Jaystonian/SuperVIC/CMicro-Keyboard/pics/CMicro-Keyboard.png

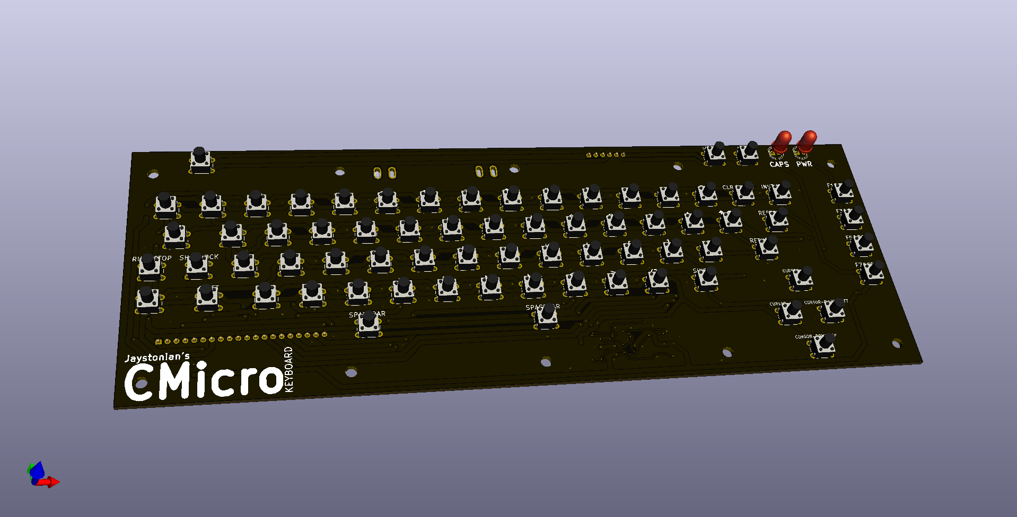
CMicro-Keyboard/pics/CMicro-Keyboard.png
