Jaystonian/SuperVIC/SuperVIC-Motherboard/pics/SuperVIC-Motherboard1.png

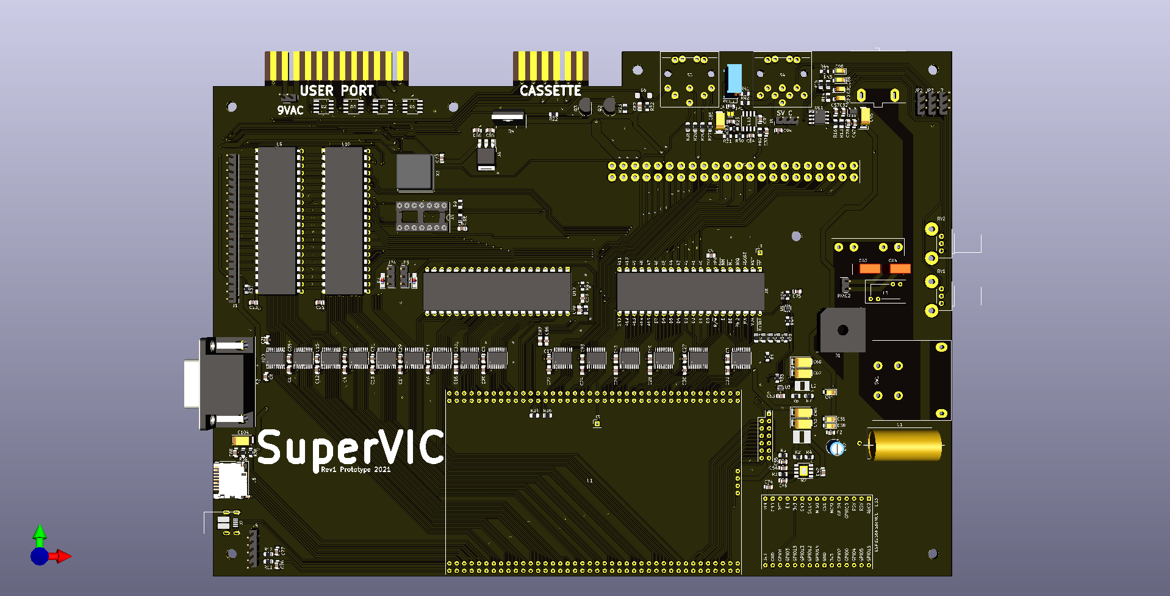
SuperVIC-Motherboard/pics/SuperVIC-Motherboard1.png
