Jaystonian/SuperVIC/SuperVIC-Motherboard/pics/IMG_20210614_160904_6.jpg

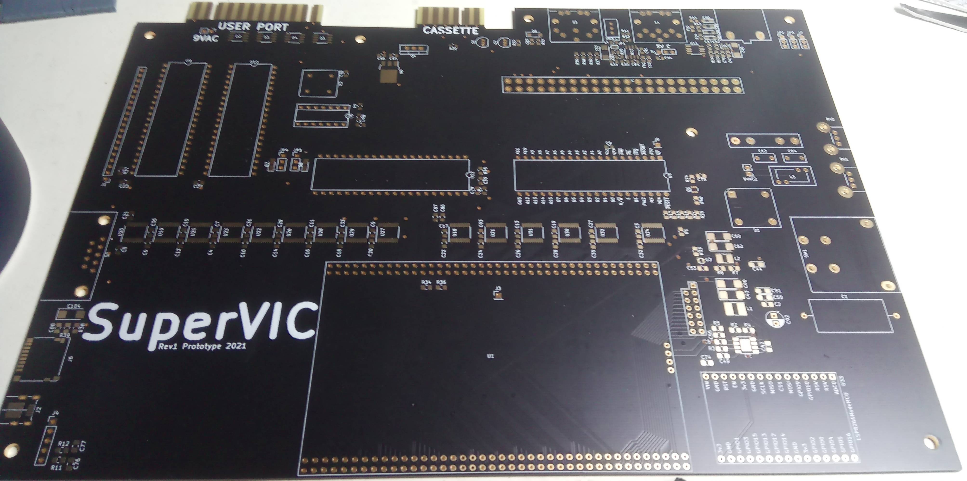
SuperVIC-Motherboard/pics/IMG_20210614_160904_6.jpg
