Jaystonian/SuperVIC/SuperVIC-STM32/pics/Capture-1.png

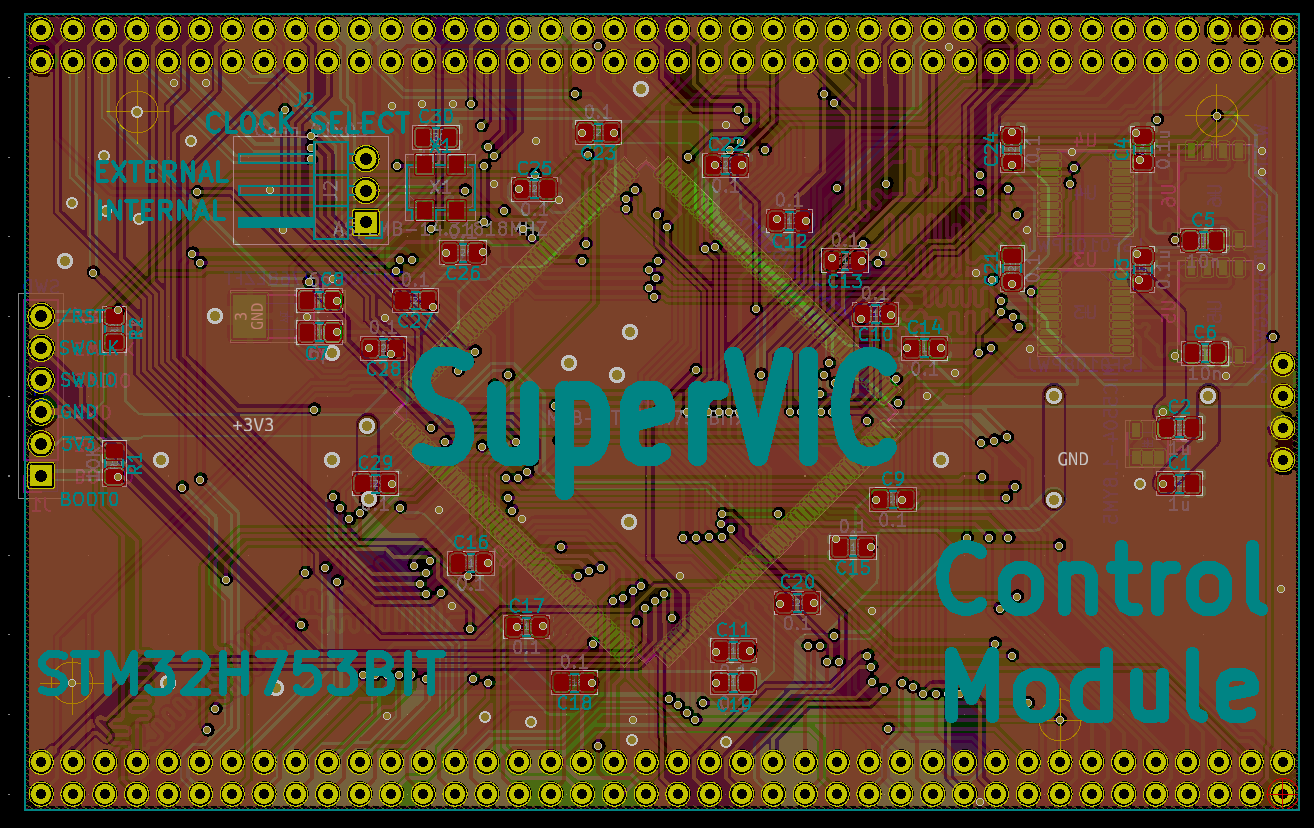
SuperVIC-STM32/pics/Capture-1.png
