Jaystonian/SuperVIC/SuperVIC-STM32/pics/SuperVIC-STM32-bottom.png

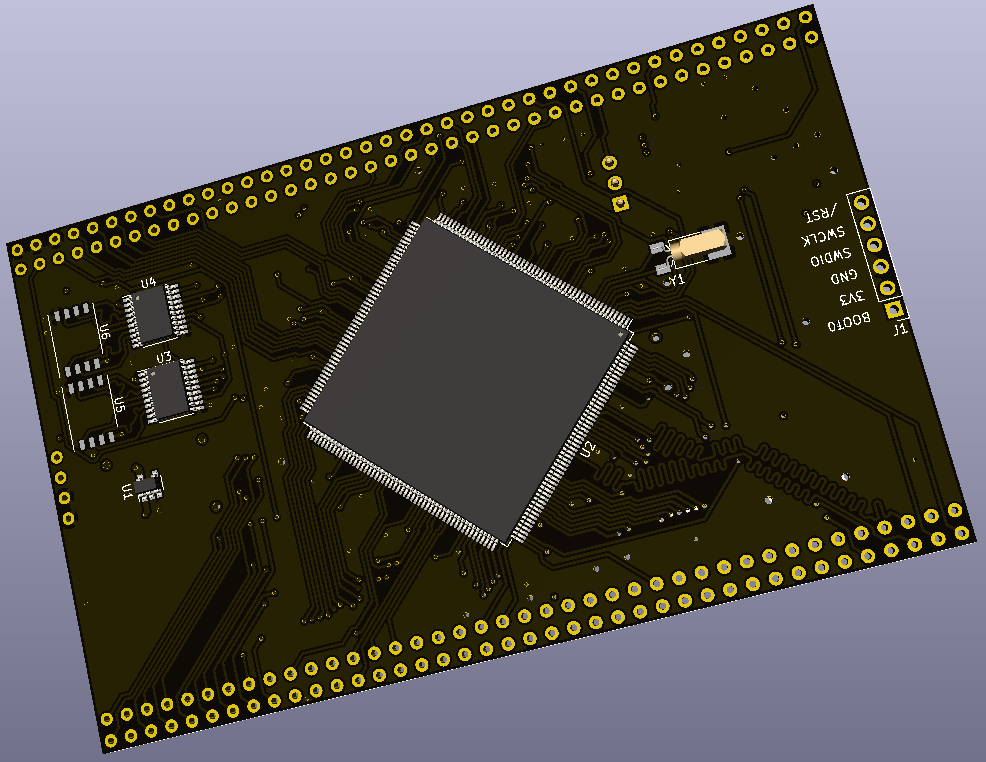
SuperVIC-STM32/pics/SuperVIC-STM32-bottom.png
