Jaystonian/SuperVIC/SuperVIC-STM32/pics/SuperVIC-STM32-top.png

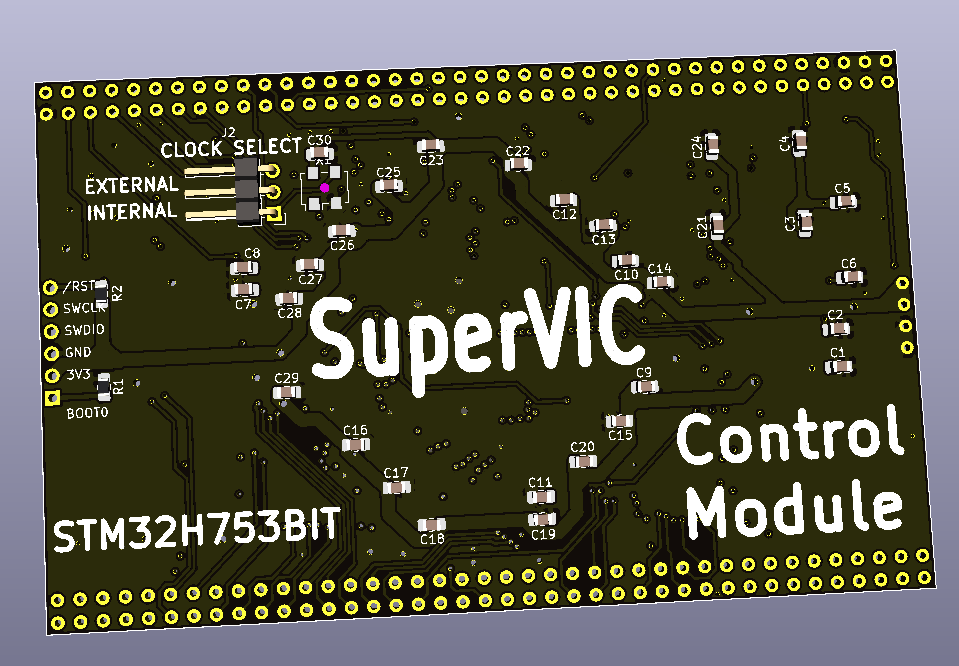
SuperVIC-STM32/pics/SuperVIC-STM32-top.png
