Jaystonian/SuperVIC/3D_Print/bottom_v1.stl

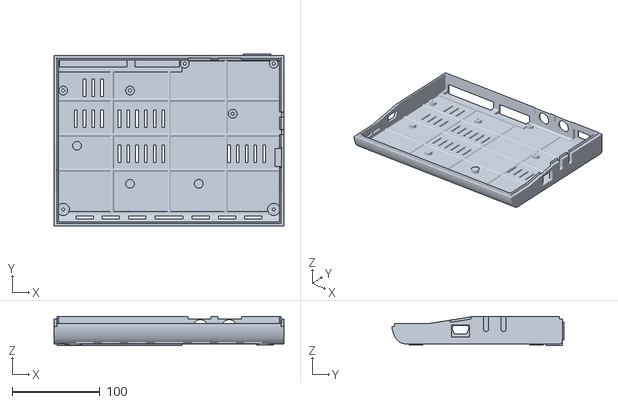
[picture p7: CAD file, 2021-06-18]
3D_Print/bottom_v1.stl
262.5 x 196.8 x 33.2
