Jaystonian/SuperVIC/CMicro-Keyboard/Print3D/protocase_rev0/cmicro-proto-external-top.stl

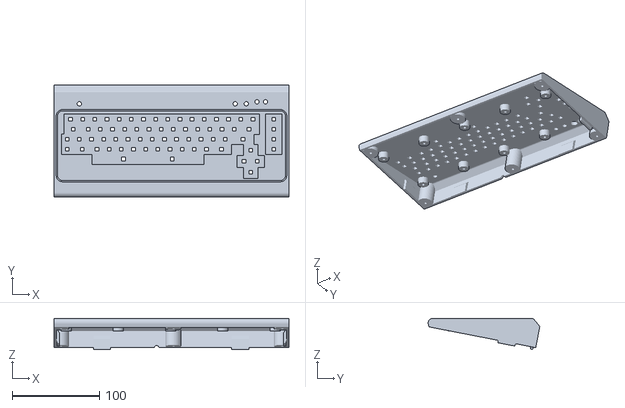
[picture p8: CAD file, 2021-06-15]
CMicro-Keyboard/Print3D/protocase_rev0/cmicro-proto-external-top.stl
270.0 x 128.3 x 35.7
