Jaystonian/SuperVIC/CMicro-Keyboard/Print3D/protocase_rev0/cmicro-proto-external-bottom.stl

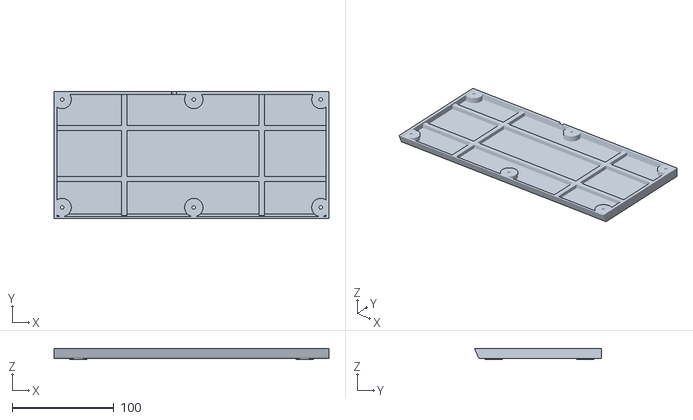
[picture p9: CAD file, 2021-06-15]
CMicro-Keyboard/Print3D/protocase_rev0/cmicro-proto-external-bottom.stl
270.0 x 125.0 x 11.2
