Jaystonian/SuperVIC/SuperVIC-STM32/SuperVIC-STM32.pdf

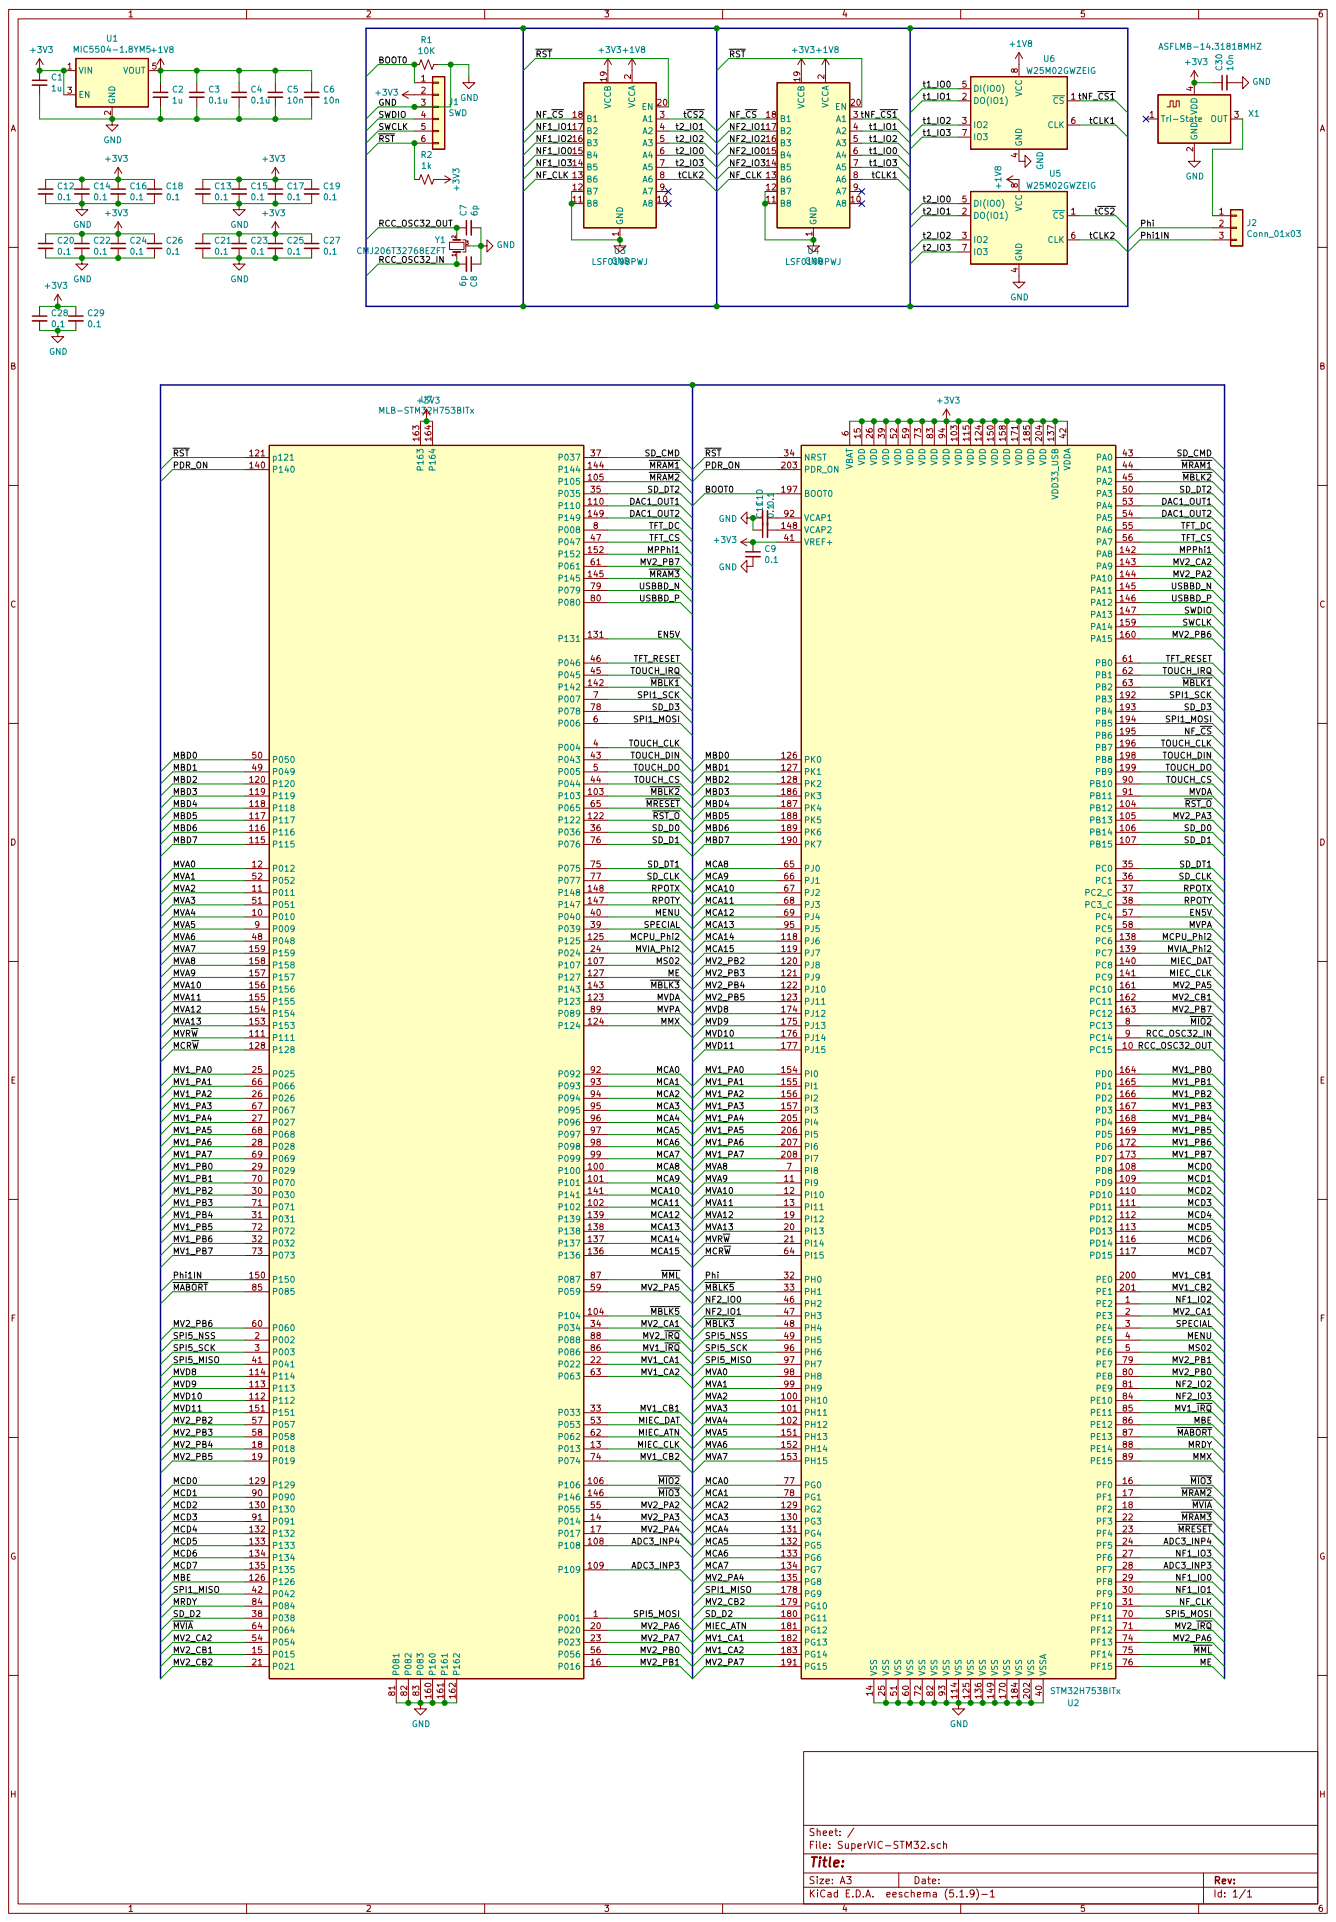
[picture p10: page 1]

6 VCAP1 92 VCAP2 148 VDD 103 VDD 115 VDD 124 VDD 15 VDD 150 VDD 158 VDD 171 VDD 185 VDD 204 VDD 26 VDD 39 VDD 52 VDD 59 VDD 73 VDD 83 VDD 94 VDD33_USB 137 VDDA 42 VREF+ 41 VSS 114 VSS 125 VSS 136 VSS 14 VSS 149 VSS 170 VSS 184 VSS 202 VSS 25 VSS 51 VSS 60 VSS 72 VSS 82 VSS 93 VSSA 40 U2 STM32H753BITx

File: SuperVIC-STM32.sch Sheet: /
