Jaystonian/SuperVIC/CMicro-Keyboard/CMicro-Keyboard.pdf

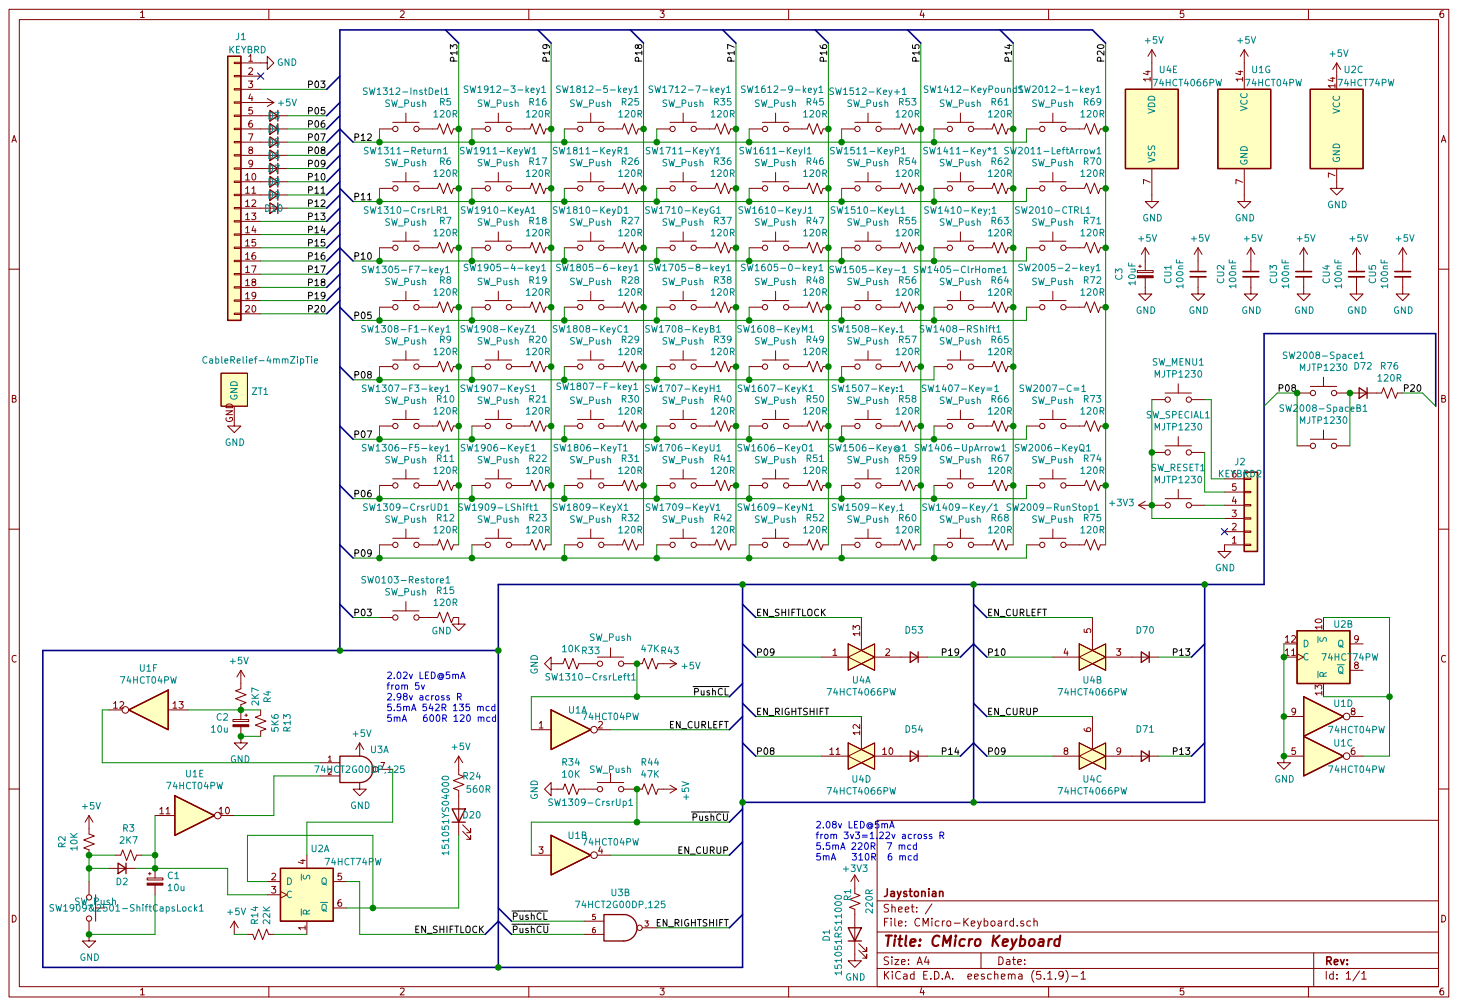
[picture p11: page 1]

File: CMicro-Keyboard.sch Sheet: / Jaystonian

Id: 1/1 Title: CMicro Keyboard
