Jaystonian/SuperVIC/SuperVIC-STM32/SuperVIC-STM32.kicad_pcb

## KiCad design SuperVIC-STM32/SuperVIC-STM32.kicad_pcb (2021-06-15)

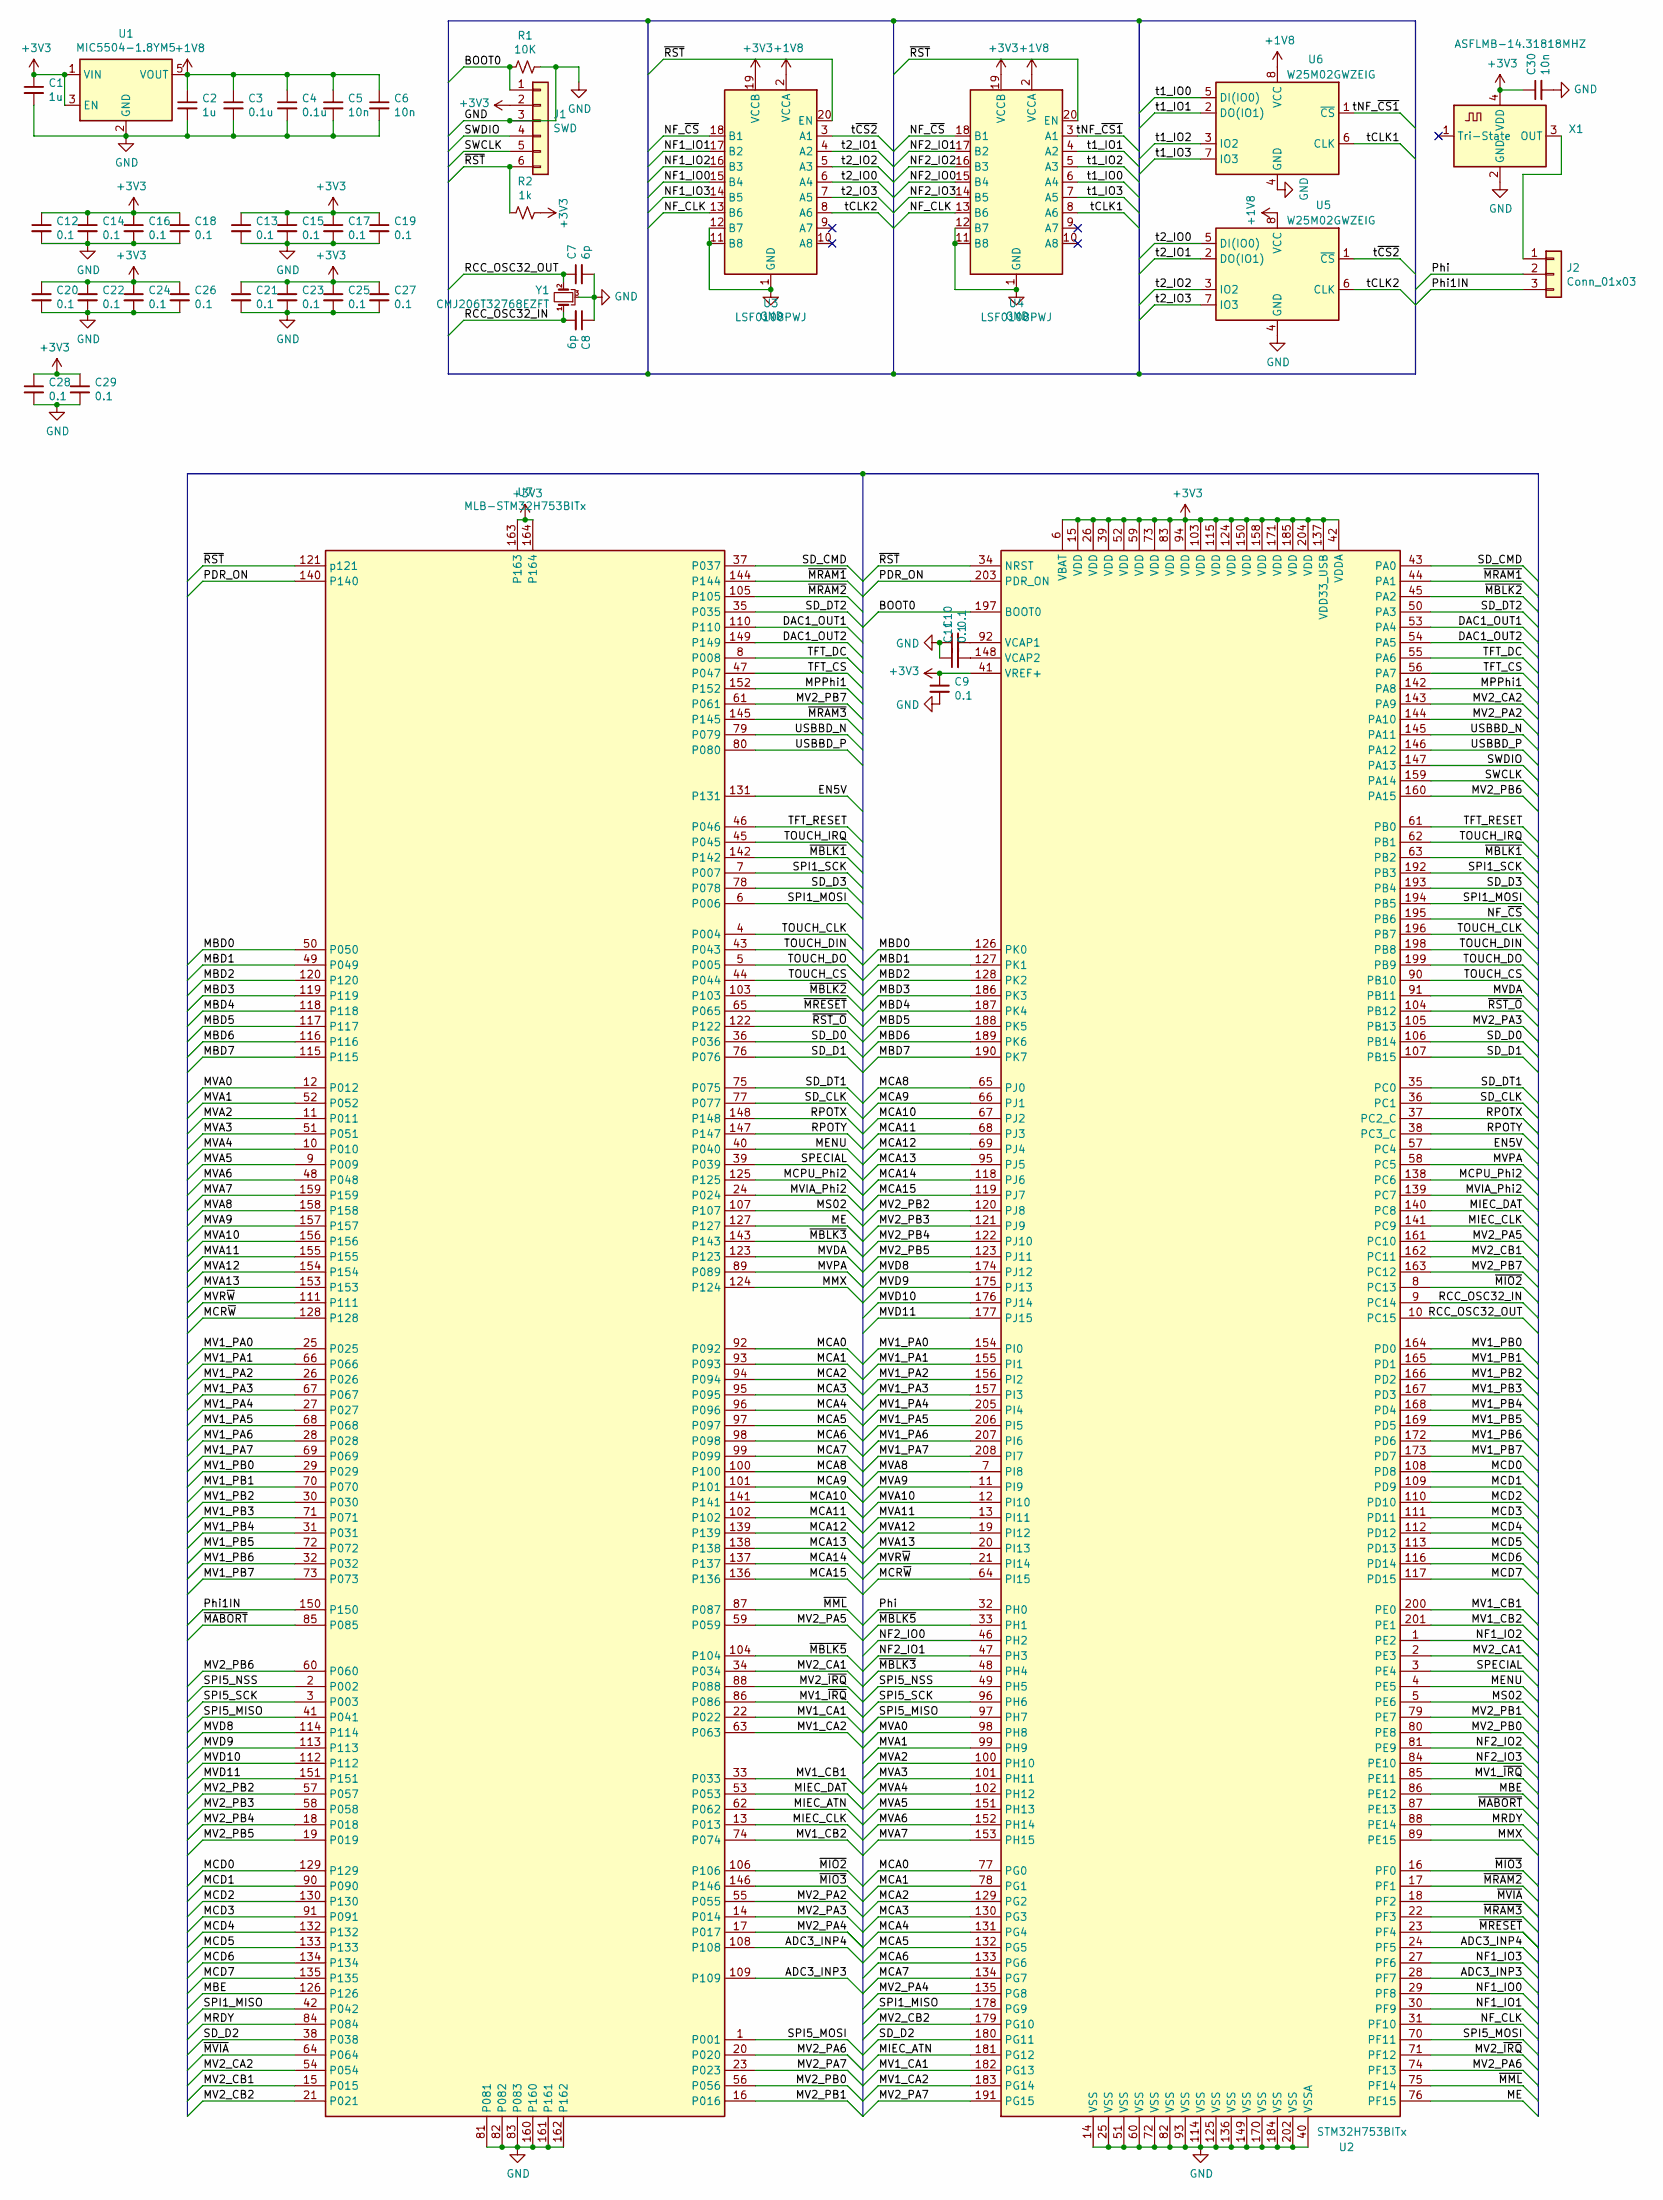
[picture p12: schematic SuperVIC-STM32.sch]

Parts:
C1, C2: 1u; C_0805_2012Metric_Pad1.15x1.40mm_HandSolder
C3, C4: 0.1u; C_0805_2012Metric_Pad1.15x1.40mm_HandSolder
C5, C6, C30: 10n; C_0805_2012Metric_Pad1.15x1.40mm_HandSolder
C7, C8: 6p; C_0805_2012Metric_Pad1.15x1.40mm_HandSolder
C9, C10, C11, C12, C13, C14, C15, C16, C17, C18, C19, C20, C21, C22, C23, C24, C25, C26, C27, C28, C29: 0.1; C_0805_2012Metric_Pad1.15x1.40mm_HandSolder
J1: SWD; PinHeader_1x06_P2.54mm_Vertical
J2: Conn_01x03; PinHeader_1x03_P2.54mm_Horizontal
R1: 10K; R_0805_2012Metric_Pad1.15x1.40mm_HandSolder
R2: 1k; R_0805_2012Metric_Pad1.15x1.40mm_HandSolder
U1: MIC5504-1.8YM5; SOT-23-5
U2: STM32H753BITx; LQFP-208_28x28mm_P0.5mm
U3, U4: LSF0108PWJ; TSSOP-20_4.4x6.5mm_P0.65mm
U5, U6: W25M02GWZEIG; WSON-8_8x6mm
U7: MLB-STM32H753BITx
X1: ASFLMB-14.31818MHZ; Oscillator_SMD_Abracon_ASF-4Pin_5.0x3.2mm_Handsoldering
Y1: CMJ206T32768EZFT; Crystal_SMD_CMJ206T

Connections:
+1V8: C2.1, C3.1, C4.1, C5.1, C6.1, U1.5 (VOUT), U3.2 (VCCA), U4.2 (VCCA), U5.8 (VCC), U6.8 (VCC)
+3V3: C1.1, C9.1, C12.1, C13.1, C14.1, C15.1, C16.1, C17.1, C18.1, C19.1, C20.1, C21.1, C22.1, C23.1, C24.1, C25.1, C26.1, C27.1, C28.1, C29.1, C30.1, J1.2, R2.1, U1.1 (VIN), U1.3 (EN), U2.6 (VBAT), U2.15 (VDD), U2.26 (VDD), U2.39 (VDD), U2.41 (VREF+), U2.42 (VDDA), U2.52 (VDD), U2.59 (VDD), U2.73 (VDD), U2.83 (VDD), U2.94 (VDD), U2.103 (VDD), U2.115 (VDD), U2.124 (VDD), U2.137 (VDD33_USB), U2.150 (VDD), U2.158 (VDD), U2.171 (VDD), U2.185 (VDD), U2.204 (VDD), U3.19 (VCCB), U4.19 (VCCB), U7.163, U7.164, X1.4 (VDD)
/ADC3_INP3: U2.28 (PF7), U7.109
/ADC3_INP4: U2.24 (PF5), U7.108
/BOOT0: J1.1, R1.2, U2.197 (BOOT0)
/DAC1_OUT1: U2.53 (PA4), U7.110
/DAC1_OUT2: U2.54 (PA5), U7.149
/EN5V: U2.57 (PC4), U7.131
/MBD0: U2.126 (PK0), U7.50
/MBD1: U2.127 (PK1), U7.49
/MBD2: U2.128 (PK2), U7.120
/MBD3: U2.186 (PK3), U7.119
/MBD4: U2.187 (PK4), U7.118
/MBD5: U2.188 (PK5), U7.117
/MBD6: U2.189 (PK6), U7.116
/MBD7: U2.190 (PK7), U7.115
/MBE: U2.86 (PE12), U7.126
/MCA0: U2.77 (PG0), U7.92
/MCA1: U2.78 (PG1), U7.93
/MCA2: U2.129 (PG2), U7.94
/MCA3: U2.130 (PG3), U7.95
/MCA4: U2.131 (PG4), U7.96
/MCA5: U2.132 (PG5), U7.97
/MCA6: U2.133 (PG6), U7.98
/MCA7: U2.134 (PG7), U7.99
/MCA8: U2.65 (PJ0), U7.100
/MCA9: U2.66 (PJ1), U7.101
/MCA10: U2.67 (PJ2), U7.141
/MCA11: U2.68 (PJ3), U7.102
/MCA12: U2.69 (PJ4), U7.139
/MCA13: U2.95 (PJ5), U7.138
/MCA14: U2.118 (PJ6), U7.137
/MCA15: U2.119 (PJ7), U7.136
/MCD0: U2.108 (PD8), U7.129
/MCD1: U2.109 (PD9), U7.90
/MCD2: U2.110 (PD10), U7.130
/MCD3: U2.111 (PD11), U7.91
/MCD4: U2.112 (PD12), U7.132
/MCD5: U2.113 (PD13), U7.133
/MCD6: U2.116 (PD14), U7.134
/MCD7: U2.117 (PD15), U7.135
/MCPU_Phi2: U2.138 (PC6), U7.125
/MCR~W: U2.64 (PI15), U7.128
/ME: U2.76 (PF15), U7.127
/MENU: U2.4 (PE5), U7.40
/MIEC_ATN: U2.181 (PG12), U7.62
/MIEC_CLK: U2.141 (PC9), U7.13
/MIEC_DAT: U2.140 (PC8), U7.53
/MMX: U2.89 (PE15), U7.124
/MPPhi1: U2.142 (PA8), U7.152
/MRDY: U2.88 (PE14), U7.84
/MS02: U2.5 (PE6), U7.107
/MV1_CA1: U2.182 (PG13), U7.22
/MV1_CA2: U2.183 (PG14), U7.63
/MV1_CB1: U2.200 (PE0), U7.33
/MV1_CB2: U2.201 (PE1), U7.74
/MV1_PA0: U2.154 (PI0), U7.25
/MV1_PA1: U2.155 (PI1), U7.66
/MV1_PA2: U2.156 (PI2), U7.26
/MV1_PA3: U2.157 (PI3), U7.67
/MV1_PA4: U2.205 (PI4), U7.27
/MV1_PA5: U2.206 (PI5), U7.68
/MV1_PA6: U2.207 (PI6), U7.28
/MV1_PA7: U2.208 (PI7), U7.69
/MV1_PB0: U2.164 (PD0), U7.29
/MV1_PB1: U2.165 (PD1), U7.70
/MV1_PB2: U2.166 (PD2), U7.30
/MV1_PB3: U2.167 (PD3), U7.71
/MV1_PB4: U2.168 (PD4), U7.31
/MV1_PB5: U2.169 (PD5), U7.72
/MV1_PB6: U2.172 (PD6), U7.32
/MV1_PB7: U2.173 (PD7), U7.73
/MV1_~IRQ: U2.85 (PE11), U7.86
/MV2_CA1: U2.2 (PE3), U7.34
/MV2_CA2: U2.143 (PA9), U7.54
/MV2_CB1: U2.162 (PC11), U7.15
/MV2_CB2: U2.179 (PG10), U7.21
/MV2_PA2: U2.144 (PA10), U7.55
/MV2_PA3: U2.105 (PB13), U7.14
/MV2_PA4: U2.135 (PG8), U7.17
/MV2_PA5: U2.161 (PC10), U7.59
/MV2_PA6: U2.74 (PF13), U7.20
/MV2_PA7: U2.191 (PG15), U7.23
/MV2_PB0: U2.80 (PE8), U7.56
/MV2_PB1: U2.79 (PE7), U7.16
/MV2_PB2: U2.120 (PJ8), U7.57
/MV2_PB3: U2.121 (PJ9), U7.58
/MV2_PB4: U2.122 (PJ10), U7.18
/MV2_PB5: U2.123 (PJ11), U7.19
/MV2_PB6: U2.160 (PA15), U7.60
/MV2_PB7: U2.163 (PC12), U7.61
/MV2_~IRQ: U2.71 (PF12), U7.88
/MVA0: U2.98 (PH8), U7.12
/MVA1: U2.99 (PH9), U7.52
/MVA2: U2.100 (PH10), U7.11
/MVA3: U2.101 (PH11), U7.51
/MVA4: U2.102 (PH12), U7.10
/MVA5: U2.151 (PH13), U7.9
/MVA6: U2.152 (PH14), U7.48
/MVA7: U2.153 (PH15), U7.159
/MVA8: U2.7 (PI8), U7.158
/MVA9: U2.11 (PI9), U7.157
/MVA10: U2.12 (PI10), U7.156
/MVA11: U2.13 (PI11), U7.155
/MVA12: U2.19 (PI12), U7.154
/MVA13: U2.20 (PI13), U7.153
/MVD8: U2.174 (PJ12), U7.114
/MVD9: U2.175 (PJ13), U7.113
/MVD10: U2.176 (PJ14), U7.112
/MVD11: U2.177 (PJ15), U7.151
/MVDA: U2.91 (PB11), U7.123
/MVIA_Phi2: U2.139 (PC7), U7.24
/MVPA: U2.58 (PC5), U7.89
/MVR~W: U2.21 (PI14), U7.111
/NF1_IO0: U2.29 (PF8), U3.15 (B4)
/NF1_IO1: U2.30 (PF9), U3.17 (B2)
/NF1_IO2: U2.1 (PE2), U3.16 (B3)
/NF1_IO3: U2.27 (PF6), U3.14 (B5)
/NF2_IO0: U2.46 (PH2), U4.15 (B4)
/NF2_IO1: U2.47 (PH3), U4.17 (B2)
/NF2_IO2: U2.81 (PE9), U4.16 (B3)
/NF2_IO3: U2.84 (PE10), U4.14 (B5)
/NF_CLK: U2.31 (PF10), U3.13 (B6), U4.13 (B6)
/NF_~CS: U2.195 (PB6), U3.18 (B1), U4.18 (B1)
/PDR_ON: U2.203 (PDR_ON), U7.140
/Phi: J2.2, U2.32 (PH0)
/Phi1IN: J2.3, U7.150
/RCC_OSC32_IN: C8.2, U2.9 (PC14), Y1.1
/RCC_OSC32_OUT: C7.1, U2.10 (PC15), Y1.2
/RPOTX: U2.37 (PC2_C), U7.148
/RPOTY: U2.38 (PC3_C), U7.147
/SD_CLK: U2.36 (PC1), U7.77
/SD_CMD: U2.43 (PA0), U7.37
/SD_D0: U2.106 (PB14), U7.36
/SD_D1: U2.107 (PB15), U7.76
/SD_D2: U2.180 (PG11), U7.38
/SD_D3: U2.193 (PB4), U7.78
/SD_DT1: U2.35 (PC0), U7.75
/SD_DT2: U2.50 (PA3), U7.35
/SPECIAL: U2.3 (PE4), U7.39
/SPI1_MISO: U2.178 (PG9), U7.42
/SPI1_MOSI: U2.194 (PB5), U7.6
/SPI1_SCK: U2.192 (PB3), U7.7
/SPI5_MISO: U2.97 (PH7), U7.41
/SPI5_MOSI: U2.70 (PF11), U7.1
/SPI5_NSS: U2.49 (PH5), U7.2
/SPI5_SCK: U2.96 (PH6), U7.3
/SWCLK: J1.5, U2.159 (PA14)
/SWDIO: J1.4, U2.147 (PA13)
/TFT_CS: U2.56 (PA7), U7.47
/TFT_DC: U2.55 (PA6), U7.8
/TFT_RESET: U2.61 (PB0), U7.46
/TOUCH_CLK: U2.196 (PB7), U7.4
/TOUCH_CS: U2.90 (PB10), U7.44
/TOUCH_DIN: U2.198 (PB8), U7.43
/TOUCH_DO: U2.199 (PB9), U7.5
/TOUCH_IRQ: U2.62 (PB1), U7.45
/USBBD_N: U2.145 (PA11), U7.79
/USBBD_P: U2.146 (PA12), U7.80
/t1_IO0: U4.6 (A4), U6.5 (DI(IO0))
/t1_IO1: U4.4 (A2), U6.2 (DO(IO1))
/t1_IO2: U4.5 (A3), U6.3 (IO2)
/t1_IO3: U4.7 (A5), U6.7 (IO3)
/t2_IO0: U3.6 (A4), U5.5 (DI(IO0))
/t2_IO1: U3.4 (A2), U5.2 (DO(IO1))
/t2_IO2: U3.5 (A3), U5.3 (IO2)
/t2_IO3: U3.7 (A5), U5.7 (IO3)
/tCLK1: U4.8 (A6), U6.6 (CLK)
/tCLK2: U3.8 (A6), U5.6 (CLK)
/tNF_~CS1: U4.3 (A1), U6.1 (~CS)
/t~CS2: U3.3 (A1), U5.1 (~CS)
/~MABORT: U2.87 (PE13), U7.85
/~MBLK1: U2.63 (PB2), U7.142
/~MBLK2: U2.45 (PA2), U7.103
/~MBLK3: U2.48 (PH4), U7.143
/~MBLK5: U2.33 (PH1), U7.104
/~MIO2: U2.8 (PC13), U7.106
/~MIO3: U2.16 (PF0), U7.146
/~MML: U2.75 (PF14), U7.87
/~MRAM1: U2.44 (PA1), U7.144
/~MRAM2: U2.17 (PF1), U7.105
/~MRAM3: U2.22 (PF3), U7.145
/~MRESET: U2.23 (PF4), U7.65
/~MVIA: U2.18 (PF2), U7.64
/~RST: J1.6, R2.2, U2.34 (NRST), U3.20 (EN), U4.20 (EN), U7.121 (p121)
/~RST_O: U2.104 (PB12), U7.122
GND: C1.2, C2.2, C3.2, C4.2, C5.2, C6.2, C7.2, C8.1, C9.2, C10.1, C11.1, C12.2, C13.2, C14.2, C15.2, C16.2, C17.2, C18.2, C19.2, C20.2, C21.2, C22.2, C23.2, C24.2, C25.2, C26.2, C27.2, C28.2, C29.2, C30.2, J1.3, R1.1, U1.2 (GND), U2.14 (VSS), U2.25 (VSS), U2.40 (VSSA), U2.51 (VSS), U2.60 (VSS), U2.72 (VSS), U2.82 (VSS), U2.93 (VSS), U2.114 (VSS), U2.125 (VSS), U2.136 (VSS), U2.149 (VSS), U2.170 (VSS), U2.184 (VSS), U2.202 (VSS), U3.1 (GND), U3.11 (B8), U3.12 (B7), U4.1 (GND), U4.11 (B8), U4.12 (B7), U5.4 (GND), U6.4 (GND), U7.81, U7.82, U7.83, U7.160, U7.161, U7.162, X1.2 (GND), Y1.3
unnamed: C10.2, U2.92 (VCAP1)
unnamed: C11.2, U2.148 (VCAP2)
unnamed: J2.1, X1.3 (OUT)

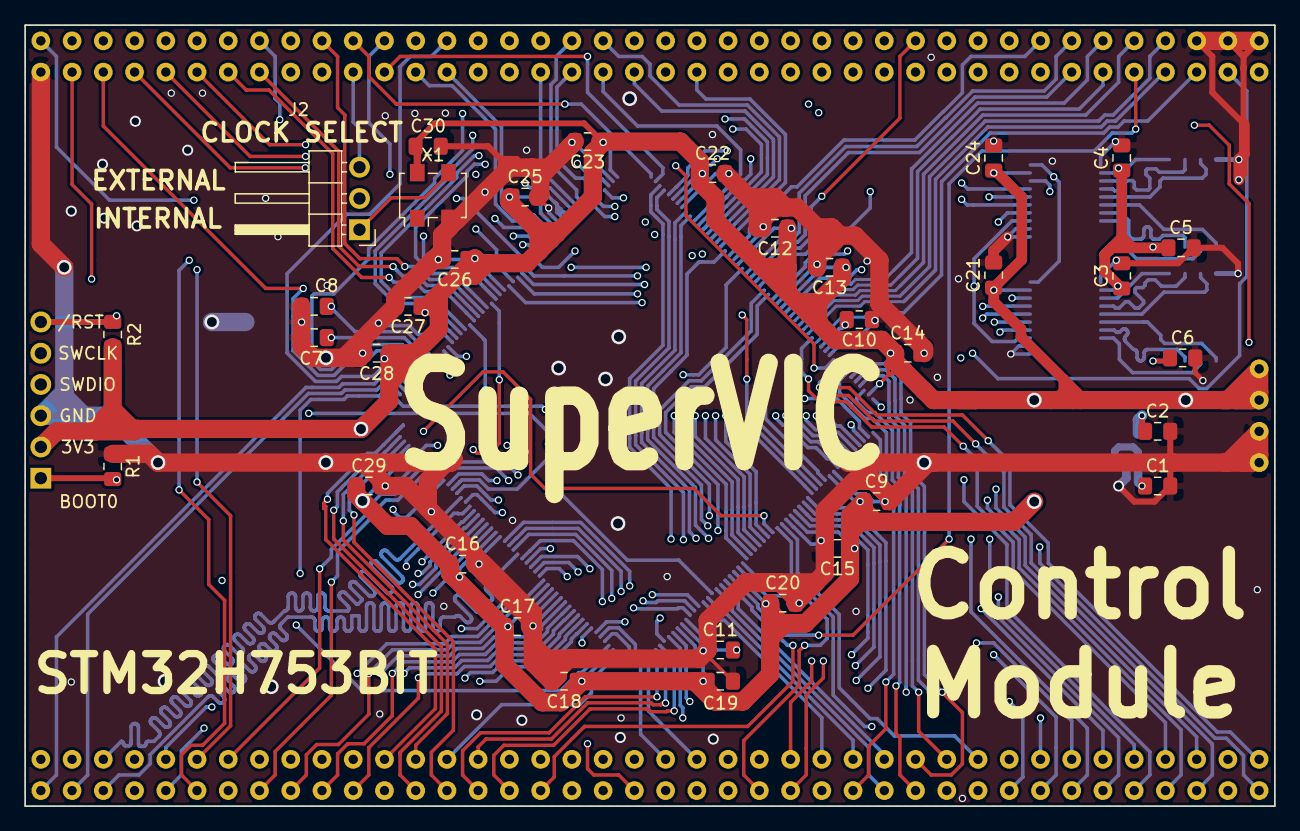
[picture p13: board SuperVIC-STM32.kicad_pcb from above]

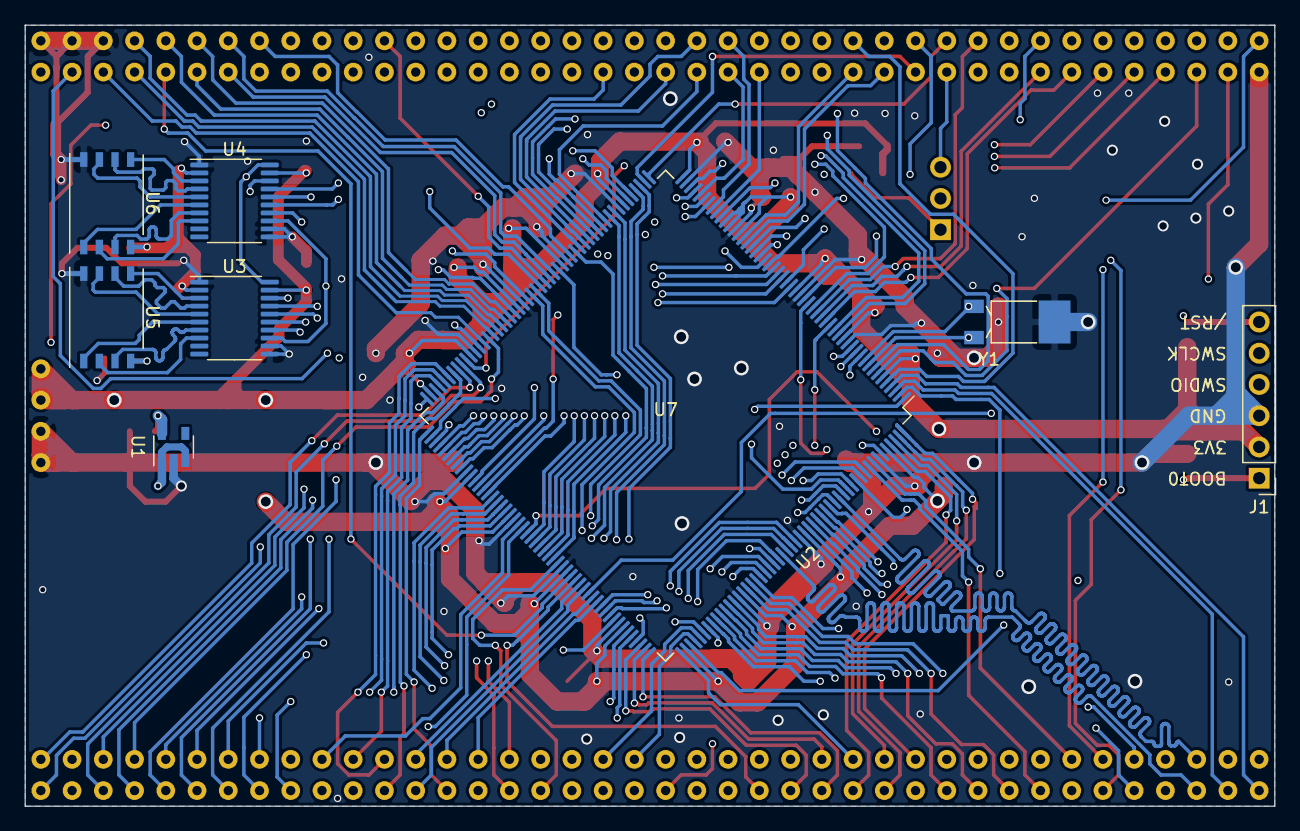
[picture p14: board SuperVIC-STM32.kicad_pcb from below]

Board: 4 copper layers, 101.6 x 63.5 mm, 43 parts (8 on the bottom side), 190 nets.
