Jaystonian/SuperVIC/CMicro-Keyboard/CMicro-Keyboard.kicad_pcb

## KiCad design CMicro-Keyboard/CMicro-Keyboard.kicad_pcb (2021-06-15)

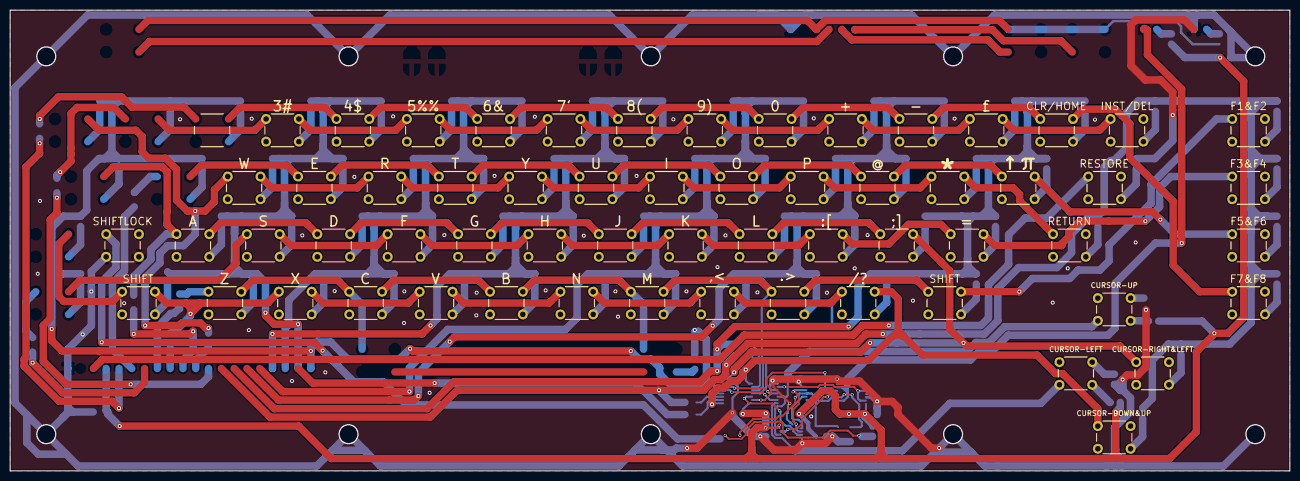
[picture p15: board CMicro-Keyboard.kicad_pcb from above]

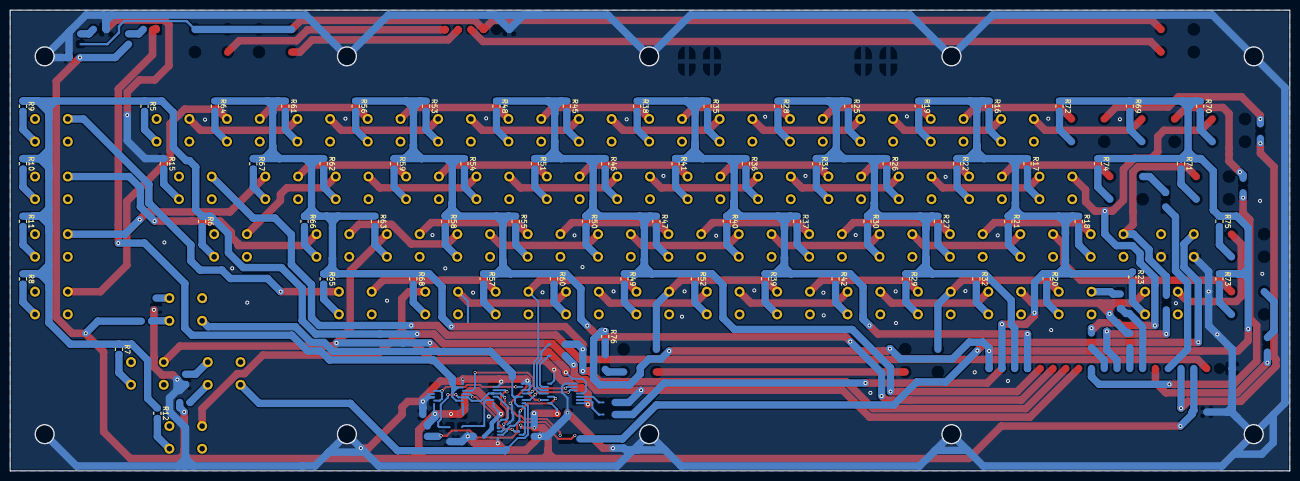
[picture p16: board CMicro-Keyboard.kicad_pcb from below]

Board: 2 copper layers, 254.0 x 91.4 mm, 126 parts (65 on the bottom side), 74 nets.

Parts:
R5, R6, R7, R8, R9, R10, R11, R12, R15, R16, R17, R18, R19, R20, R21, R22, R23, R25, R26, R27, R28, R29, R30, R31, R32, R35, R36, R37, R38, R39, R40, R41, R42, R45, R46, R47, R48, R49, R50, R51, R52, R53, R54, R55, R56, R57, R58, R59, R60, R61, R62, R63, R64, R65, R66, R67, R68, R69, R70, R71, R72, R73, R74, R75, R76: 120R; R_0805_2012Metric_Pad1.15x1.40mm_HandSolder
SW0103-Restore1, SW1305-F7-key1, SW1306-F5-key1, SW1307-F3-key1, SW1308-F1-Key1, SW1309-CrsrUD1, SW1309-CrsrUp1, SW1310-CrsrLR1, SW1310-CrsrLeft1, SW1311-Return1, SW1312-InstDel1, SW1405-ClrHome1, SW1406-UpArrow1, SW1407-Key=1, SW1408-RShift1, SW1409-Key/1, SW1410-Key;1, SW1411-Key*1, SW1412-KeyPound1, SW1505-Key-1, SW1506-Key@1, SW1507-Key:1, SW1508-Key.1, SW1509-Key,1, SW1510-KeyL1, SW1511-KeyP1, SW1512-Key+1, SW1605-0-key1, SW1606-KeyO1, SW1607-KeyK1, SW1608-KeyM1, SW1609-KeyN1, SW1610-KeyJ1, SW1611-KeyI1, SW1612-9-key1, SW1705-8-key1, SW1706-KeyU1, SW1707-KeyH1, SW1708-KeyB1, SW1709-KeyV1, SW1710-KeyG1, SW1711-KeyY1, SW1712-7-key1, SW1805-6-key1, SW1806-KeyT1, SW1807-F-key1, SW1808-KeyC1, SW1809-KeyX1, SW1810-KeyD1, SW1811-KeyR1, SW1812-5-key1, SW1905-4-key1, SW1906-KeyE1, SW1907-KeyS1, SW1908-KeyZ1, SW1909&2501-ShiftCapsLock1, SW1909-LShift1, SW1910-KeyA1, SW1911-KeyW1, SW1912-3-key1, SW2005-2-key1: SW_Push; SW_PUSH_6mm_H8mm

Connections:
/P05: SW1305-F7-key1.1, SW1405-ClrHome1.1, SW1505-Key-1.1, SW1605-0-key1.1, SW1705-8-key1.1, SW1805-6-key1.1, SW1905-4-key1.1
/P06: SW1306-F5-key1.1, SW1406-UpArrow1.1, SW1506-Key@1.1, SW1606-KeyO1.1, SW1706-KeyU1.1, SW1806-KeyT1.1, SW1906-KeyE1.1
/P07: SW1307-F3-key1.1, SW1407-Key=1.1, SW1507-Key:1.1, SW1607-KeyK1.1, SW1707-KeyH1.1, SW1807-F-key1.1, SW1907-KeyS1.1
/P08: SW1308-F1-Key1.1, SW1408-RShift1.1, SW1508-Key.1.1, SW1608-KeyM1.1, SW1708-KeyB1.1, SW1808-KeyC1.1, SW1908-KeyZ1.1
/P09: SW1309-CrsrUD1.1, SW1409-Key/1.1, SW1509-Key,1.1, SW1609-KeyN1.1, SW1709-KeyV1.1, SW1809-KeyX1.1, SW1909-LShift1.1
/P10: SW1310-CrsrLR1.1, SW1410-Key;1.1, SW1510-KeyL1.1, SW1610-KeyJ1.1, SW1710-KeyG1.1, SW1810-KeyD1.1, SW1910-KeyA1.1
/P11: SW1311-Return1.1, SW1411-Key*1.1, SW1511-KeyP1.1, SW1611-KeyI1.1, SW1711-KeyY1.1, SW1811-KeyR1.1, SW1911-KeyW1.1
/P12: SW1312-InstDel1.1, SW1412-KeyPound1.1, SW1512-Key+1.1, SW1612-9-key1.1, SW1712-7-key1.1, SW1812-5-key1.1, SW1912-3-key1.1
/P13: R5.1, R6.1, R7.1, R8.1, R9.1, R10.1, R11.1, R12.1
/P14: R61.1, R62.1, R63.1, R64.1, R65.1, R66.1, R67.1, R68.1
/P15: R53.1, R54.1, R55.1, R56.1, R57.1, R58.1, R59.1, R60.1
/P16: R45.1, R46.1, R47.1, R48.1, R49.1, R50.1, R51.1, R52.1
/P17: R35.1, R36.1, R37.1, R38.1, R39.1, R40.1, R41.1, R42.1
/P18: R25.1, R26.1, R27.1, R28.1, R29.1, R30.1, R31.1, R32.1
/P19: R16.1, R17.1, R18.1, R19.1, R20.1, R21.1, R22.1, R23.1
/P20: R69.1, R70.1, R71.1, R72.1, R73.1, R74.1, R75.1, R76.1
GND: R15.1, SW1909&2501-ShiftCapsLock1.2
unnamed: R5.2, SW1312-InstDel1.2
unnamed: R6.2, SW1311-Return1.2
unnamed: R7.2, SW1310-CrsrLR1.2
unnamed: R8.2, SW1305-F7-key1.2
unnamed: R9.2, SW1308-F1-Key1.2
unnamed: R10.2, SW1307-F3-key1.2
unnamed: R11.2, SW1306-F5-key1.2
unnamed: R12.2, SW1309-CrsrUD1.2
unnamed: R15.2, SW0103-Restore1.2
unnamed: R16.2, SW1912-3-key1.2
unnamed: R17.2, SW1911-KeyW1.2
unnamed: R18.2, SW1910-KeyA1.2
unnamed: R19.2, SW1905-4-key1.2
unnamed: R20.2, SW1908-KeyZ1.2
unnamed: R21.2, SW1907-KeyS1.2
unnamed: R22.2, SW1906-KeyE1.2
unnamed: R23.2, SW1909-LShift1.2
unnamed: R25.2, SW1812-5-key1.2
unnamed: R26.2, SW1811-KeyR1.2
unnamed: R27.2, SW1810-KeyD1.2
unnamed: R28.2, SW1805-6-key1.2
unnamed: R29.2, SW1808-KeyC1.2
unnamed: R30.2, SW1807-F-key1.2
unnamed: R31.2, SW1806-KeyT1.2
unnamed: R32.2, SW1809-KeyX1.2
unnamed: R35.2, SW1712-7-key1.2
unnamed: R36.2, SW1711-KeyY1.2
unnamed: R37.2, SW1710-KeyG1.2
unnamed: R38.2, SW1705-8-key1.2
unnamed: R39.2, SW1708-KeyB1.2
unnamed: R40.2, SW1707-KeyH1.2
unnamed: R41.2, SW1706-KeyU1.2
unnamed: R42.2, SW1709-KeyV1.2
unnamed: R45.2, SW1612-9-key1.2
unnamed: R46.2, SW1611-KeyI1.2
unnamed: R47.2, SW1610-KeyJ1.2
unnamed: R48.2, SW1605-0-key1.2
unnamed: R49.2, SW1608-KeyM1.2
unnamed: R50.2, SW1607-KeyK1.2
unnamed: R51.2, SW1606-KeyO1.2
unnamed: R52.2, SW1609-KeyN1.2
unnamed: R53.2, SW1512-Key+1.2
unnamed: R54.2, SW1511-KeyP1.2
unnamed: R55.2, SW1510-KeyL1.2
unnamed: R56.2, SW1505-Key-1.2
unnamed: R57.2, SW1508-Key.1.2
unnamed: R58.2, SW1507-Key:1.2
unnamed: R59.2, SW1506-Key@1.2
unnamed: R60.2, SW1509-Key,1.2
unnamed: R61.2, SW1412-KeyPound1.2
unnamed: R62.2, SW1411-Key*1.2
unnamed: R63.2, SW1410-Key;1.2
unnamed: R64.2, SW1405-ClrHome1.2
unnamed: R65.2, SW1408-RShift1.2
unnamed: R66.2, SW1407-Key=1.2
unnamed: R67.2, SW1406-UpArrow1.2
unnamed: R68.2, SW1409-Key/1.2
